oyeniyihakeem08-blip/child-wearable-notification-bracelet/Docs/Childcare website screnshot.png

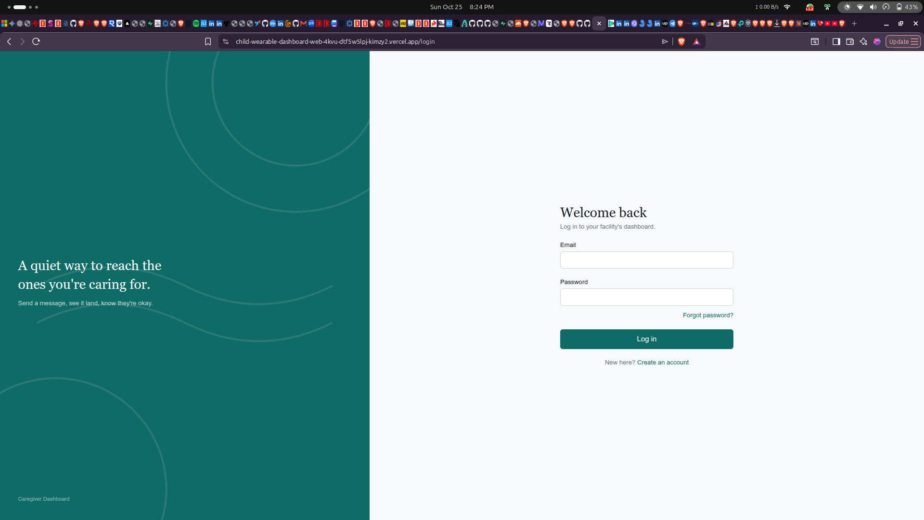
Docs/Childcare website screnshot.png
