oyeniyihakeem08-blip/child-wearable-notification-bracelet/Docs/dashboard.png

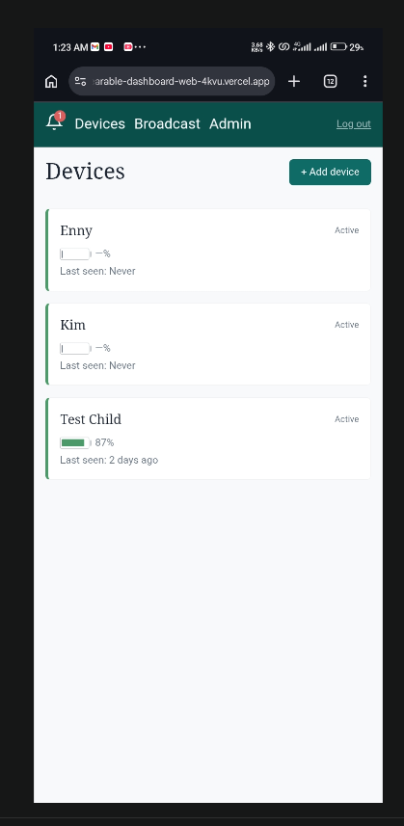
Docs/dashboard.png
