oyeniyihakeem08-blip/child-wearable-notification-bracelet/Child wereble Fabrication files/Bom.csv

Designator | Footprint | Quantity | Value | LCSC Part #
C1, C6, C7 | 0603 | 3 | 1uf | C59782
C2 | 0603 | 1 | 0.1uf | C15725
C3, C4, C5 | 0603 | 3 | 10uf | C19702
D1 | D_SOD-123 | 1 | 1N4148W | C81598
J3 | CON_5034801200_MOL | 1 | 5034801200 | C3169773
Q1, Q2 | SOT-23 | 2 | AO3400A | C347475
R1, R10, R2, R5, R7, R8, R9 | 0603 | 7 | 10k | C844918
R11, R18, R19 | 0603 | 3 | 4.7k | C844931
R12 | 0603 | 1 | 3.3k | C844928
R13 | 0603 | 1 | 20M | C422963
R14, R16, R17 | 0603 | 3 | 1M | C844922
R15 | 0603 | 1 | 1.05M | C54531148
R20, R3 | 0603 | 2 | 100r | C844917
R21, R4 | 0603 | 2 | 100k | C844916
R6 | 0603 | 1 | 8.2r | C2998143
S1 | SW_TS-1187A-B-A-B | 1 | TS-1187A-B-A-B | C318884
U1 | SOT-23-5 | 1 | AP2112K-3.3 | C51118
U2 | ESP32-S3-WROOM-1 | 1 | ESP32-S3-WROOM-1-N8R8 | C2913201
U3 | VQFN-16-1EP_3x3mm_P0.5mm_EP1.6x1.6mm | 1 | BQ24074RGT | C54313
U5 | 21-0168E_T822-3_MXM | 1 | MAX17048G+T10 | C2682616
U6 | SOT65P210X110-5N | 1 | TLV3691IDCKR | C180352
