oyeniyihakeem08-blip/child-wearable-notification-bracelet/3D models/Fuel guage 21-0168E_T822-3_MXM.step

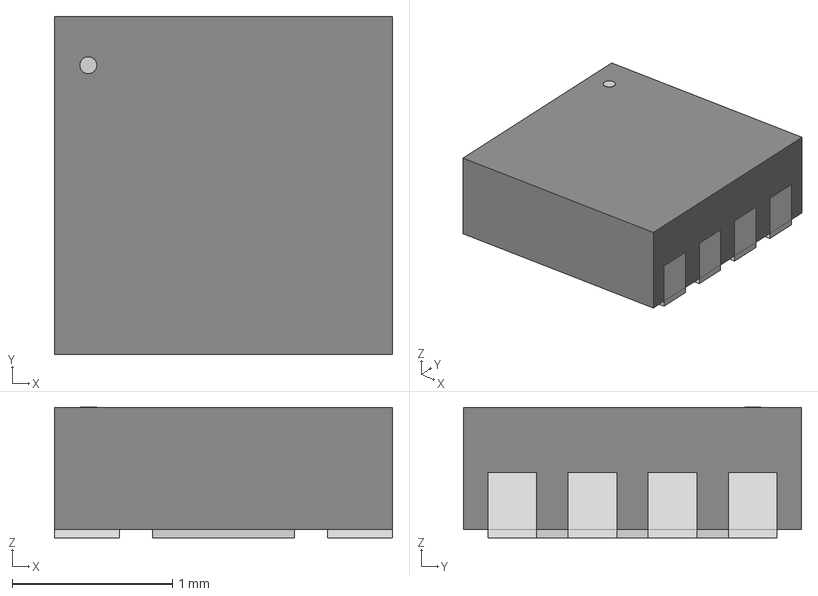
[picture p10: CAD file, 2026-10-25]
3D models/Fuel guage 21-0168E_T822-3_MXM.step
2.11 x 2.11 x 0.815 mm
