oyeniyihakeem08-blip/child-wearable-notification-bracelet/Child wereble Fabrication files/PCB 3D model/Child wereable PCB 3D model.step

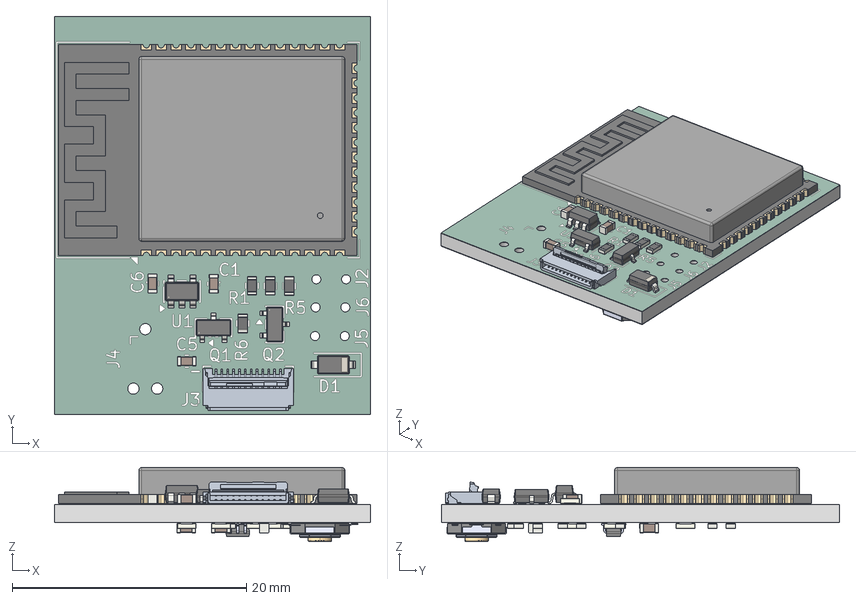
[picture p11: CAD file, 2026-10-25]
Child wereble Fabrication files/PCB 3D model/Child wereable PCB 3D model.step
27.0 x 34.0 x 6.33 mm
R_0603_1608Metric x 21
SOT-23 x 2
D_SOD-123
SOT-23-5
C_0603_1608Metric x 7
ESP32-S3-WROOM-1
TS-1187A-B-A-B
DCK5
Child wereable_silkscreen x 2
Child wereable_soldermask x 2
Child wereable_PCB
