oyeniyihakeem08-blip/child-wearable-notification-bracelet/Child wereble Fabrication files/PDFs/Front Fab.pdf

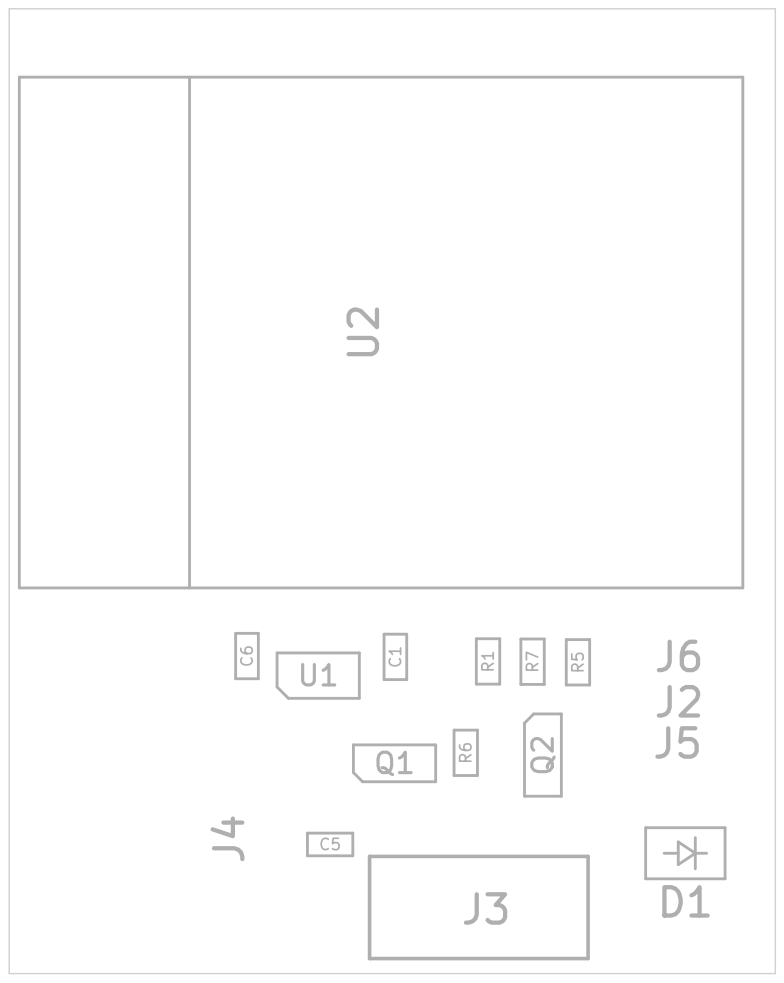
[picture p12: page 1]
