oyeniyihakeem08-blip/child-wearable-notification-bracelet/Child wereble Fabrication files/PDFs/Schematic.pdf

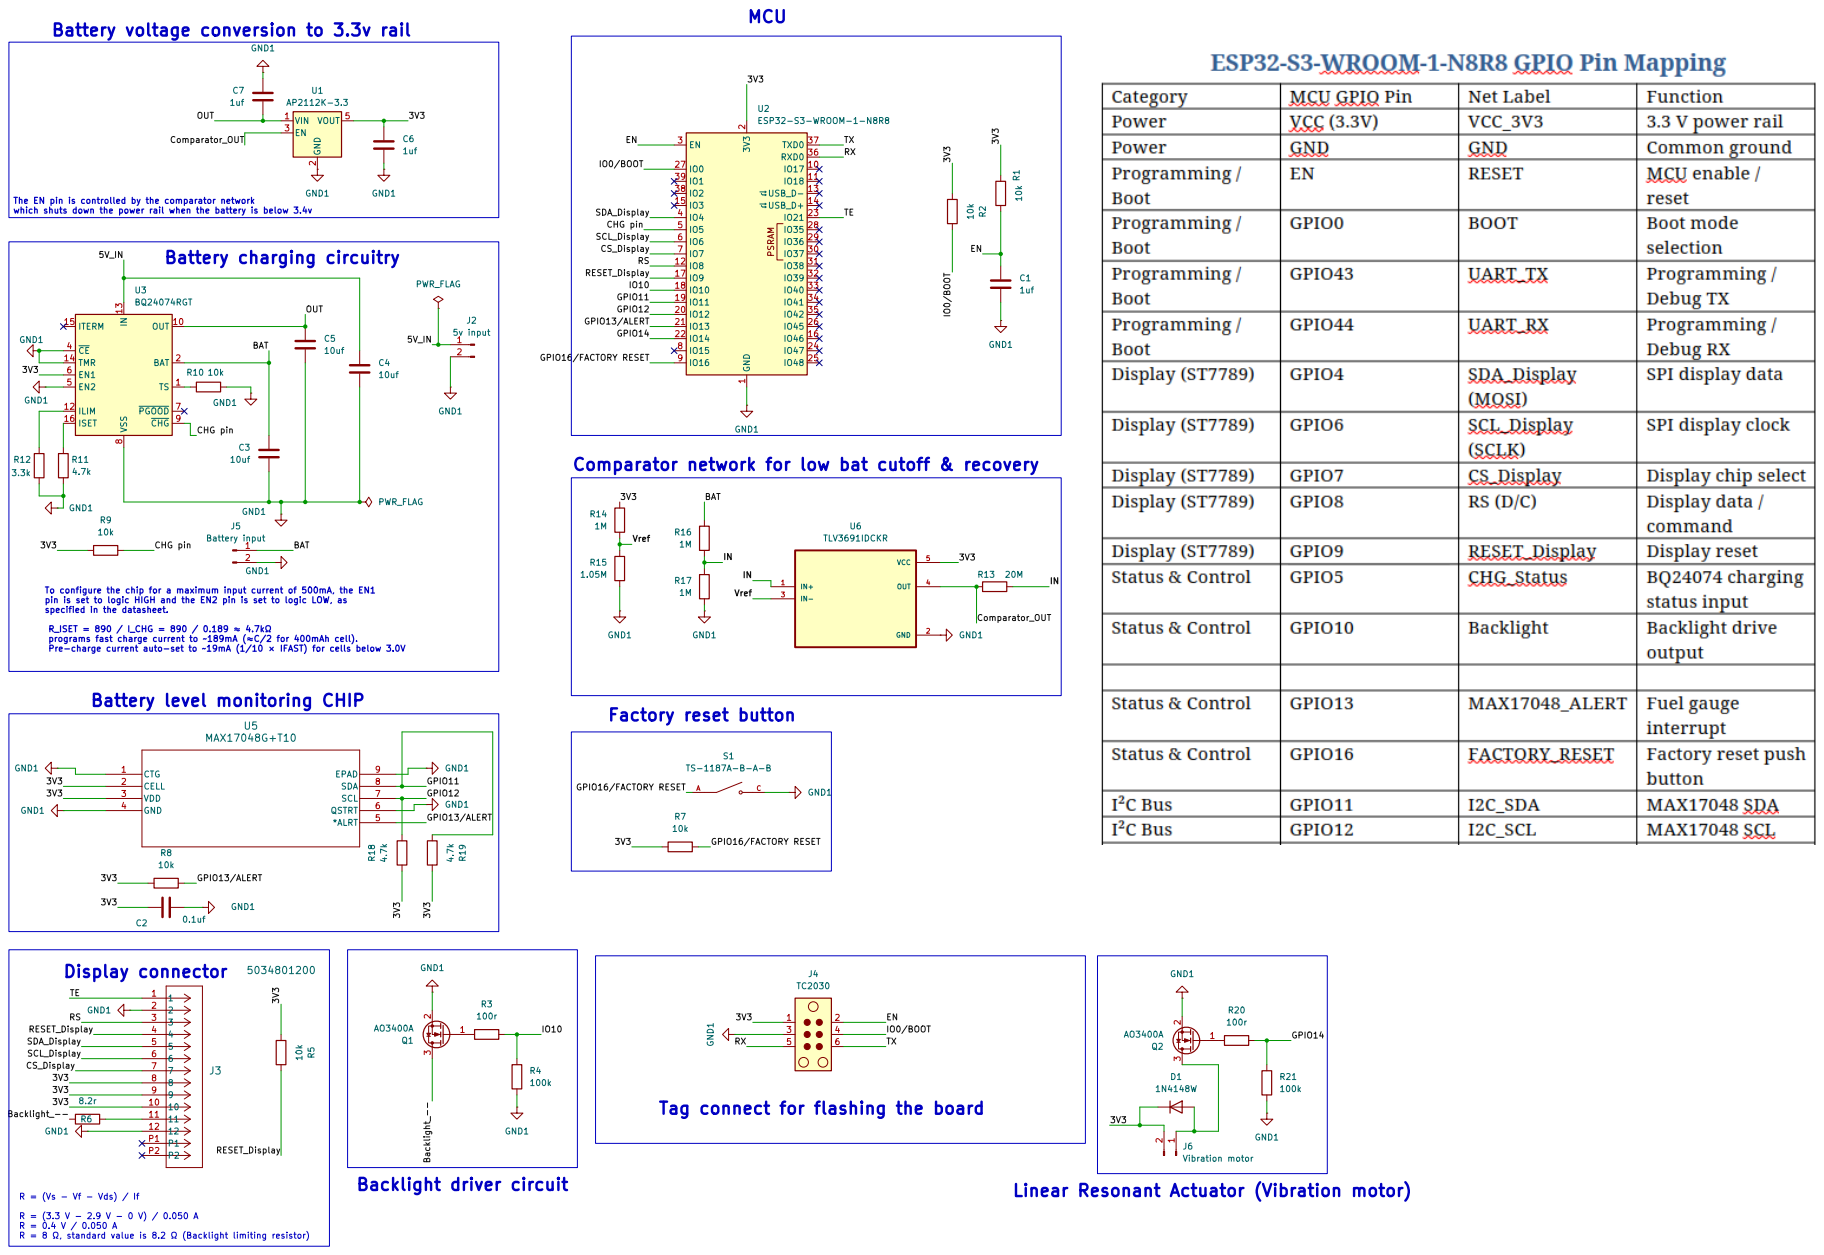
[picture p13: page 1]
