oyeniyihakeem08-blip/child-wearable-notification-bracelet/Docs/Back Fab.pdf

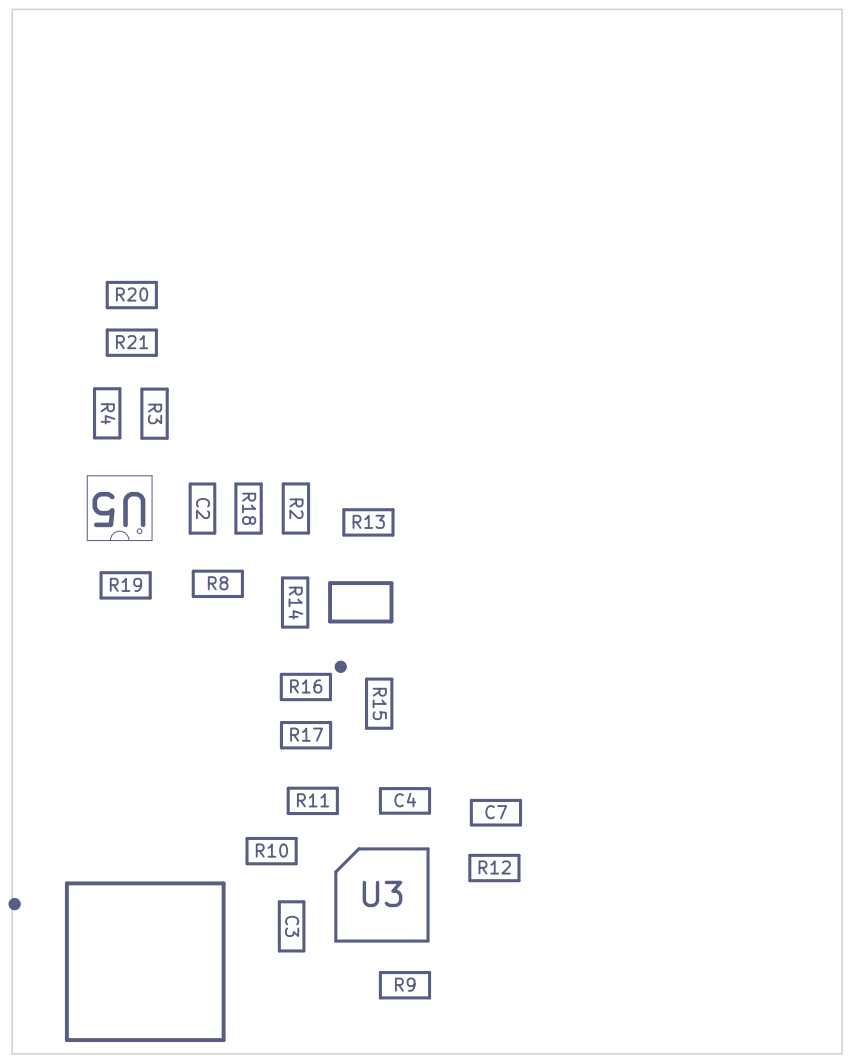
[picture p14: page 1]
