oyeniyihakeem08-blip/child-wearable-notification-bracelet/Child wereable.kicad_pcb

## KiCad design Child wereable.kicad_pcb (2026-10-25)

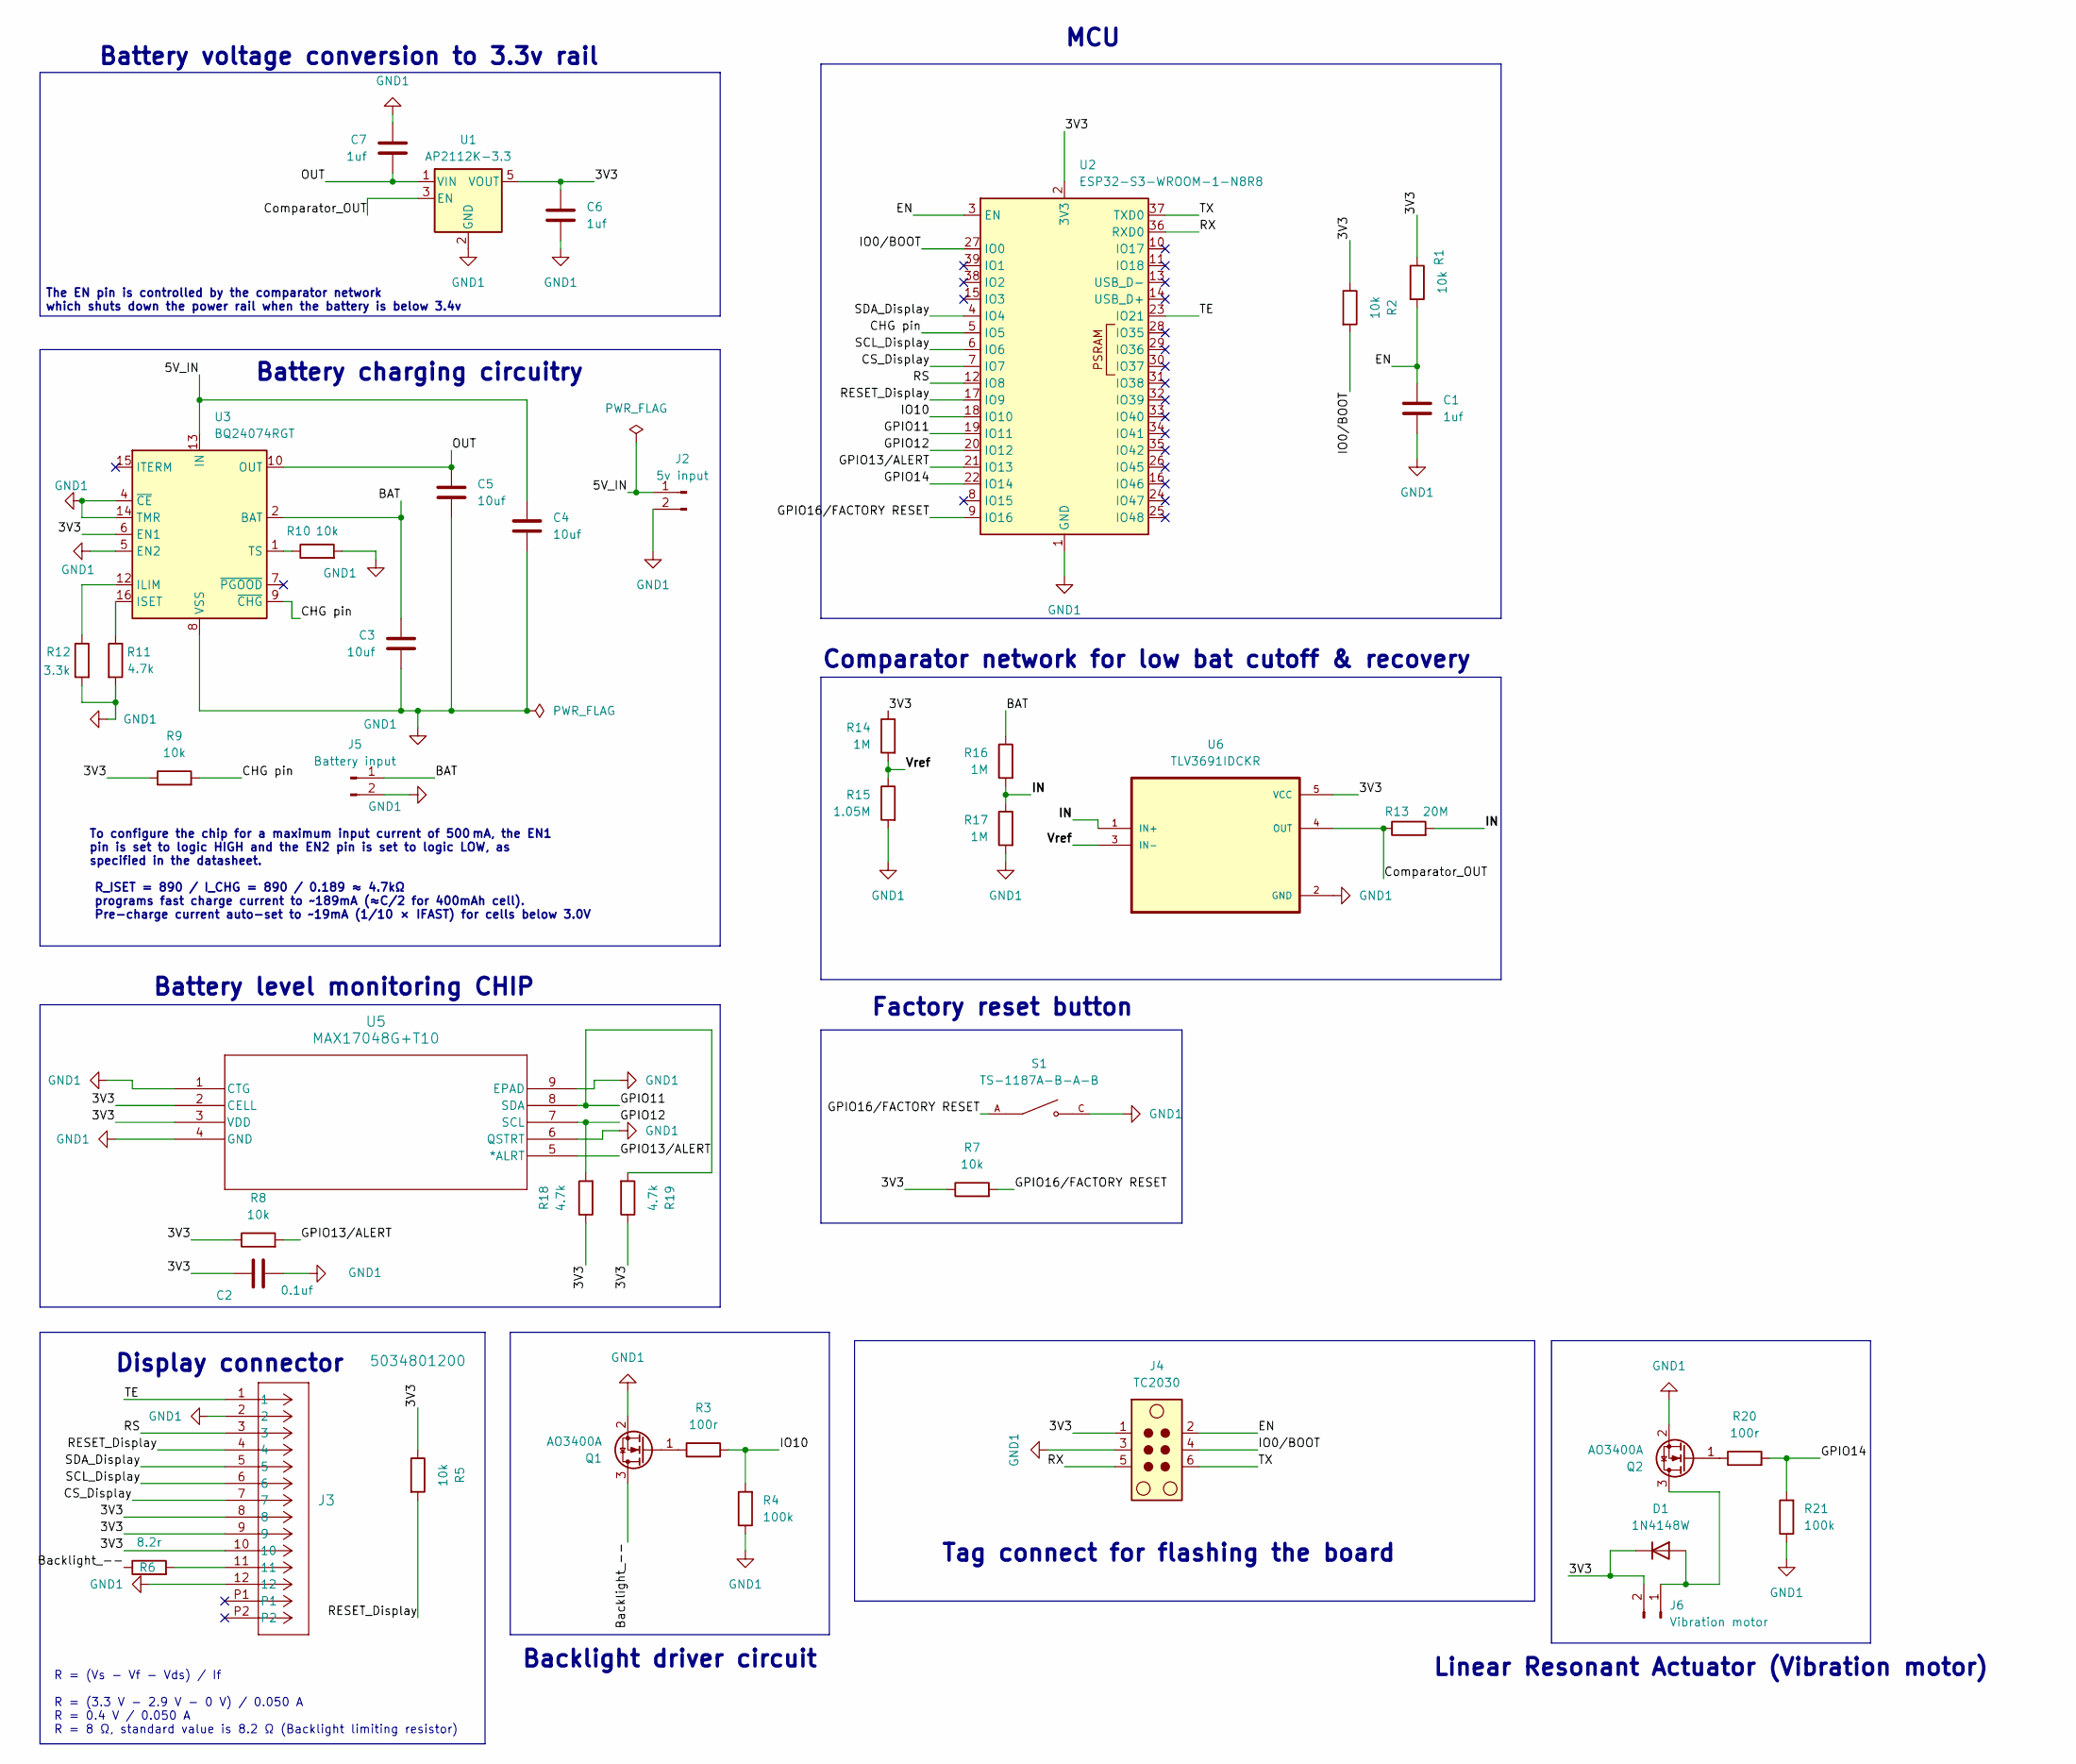
[picture p15: schematic Child wereable.kicad_sch]

Parts:
C1, C6, C7: 1uf; C_0603_1608Metric; LCSC PART NO C59782
C2: 0.1uf; C_0603_1608Metric; LCSC PART NO C15725
C3, C4, C5: 10uf; C_0603_1608Metric; LCSC PART NO C19702
D1: 1N4148W; D_SOD-123; LCSC PART NO C81598
J2: 5v input; TestPoint_2Pads_Pitch2.54mm_Drill0.8mm
J3: 5034801200; CON_5034801200_MOL; LCSC PART NO C3169773
J4: TC2030; Tag-Connect_TC2030-IDC-NL_2x03_P1.27mm_Vertical
J5: Battery input; TestPoint_2Pads_Pitch2.54mm_Drill0.8mm
J6: Vibration motor; TestPoint_2Pads_Pitch2.54mm_Drill0.8mm
Q1, Q2: AO3400A; SOT-23; LCSC PART NO C347475
R1, R2, R5, R7, R8, R9, R10: 10k; R_0603_1608Metric; LCSC PART NO C844918
R3, R20: 100r; R_0603_1608Metric; LCSC PART NO C844917
R4, R21: 100k; R_0603_1608Metric; LCSC PART NO C844916
R6: 8.2r; R_0603_1608Metric; LCSC PART NO C2998143
R11, R18, R19: 4.7k; R_0603_1608Metric; LCSC PART NO C844931
R12: 3.3k; R_0603_1608Metric; LCSC PART NO C844928
R13: 20M; R_0603_1608Metric; LCSC PART NO C422963
R14, R16, R17: 1M; R_0603_1608Metric; LCSC PART NO C844922
R15: 1.05M; R_0603_1608Metric; LCSC PART NO C54531148
S1: TS-1187A-B-A-B; SW_TS-1187A-B-A-B; PARTREV A0; LCSC PART NO C318884
U1: AP2112K-3.3; SOT-23-5; LCSC PART NO C51118
U2: ESP32-S3-WROOM-1-N8R8; ESP32-S3-WROOM-1; LCSC PART NO C2913201
U3: BQ24074RGT; VQFN-16-1EP_3x3mm_P0.5mm_EP1.6x1.6mm; LCSC PART NO C54313
U5: MAX17048G+T10; 21-0168E_T822-3_MXM; LCSC PART NO C2682616
U6: TLV3691IDCKR; SOT65P210X110-5N; LCSC PART NO C180352

Connections:
/3V3: C2.1, C6.1, D1.1 (K), J3.8, J3.9, J3.10, J4.1, J6.2, R1.1, R2.1, R5.1, R7.1, R8.1, R9.1, R14.1, R18.1, R19.1, U1.5 (VOUT), U2.2 (3V3), U3.6 (EN1), U5.2 (CELL), U5.3 (VDD), U6.5 (VCC)
/5V_IN: C4.1, J2.1, U3.13 (IN)
/BAT: C3.1, J5.1, R16.1, U3.2 (BAT), U3.3 (BAT)
/Backlight_--: Q1.3 (D), R6.1
/CHG pin: R9.2, U2.5 (IO5), U3.9 (~CHG)
/CS_Display: J3.7, U2.7 (IO7)
/Comparator_OUT: R13.1, U1.3 (EN), U6.4 (OUT)
/EN: C1.1, J4.2, R1.2, U2.3 (EN)
/GPIO11: R19.2, U2.19 (IO11), U5.8 (SDA)
/GPIO12: R18.2, U2.20 (IO12), U5.7 (SCL)
/GPIO13/ALERT: R8.2, U2.21 (IO13), U5.5 (*ALRT)
/GPIO14: R20.2, R21.2, U2.22 (IO14)
/GPIO16/FACTORY RESET: R7.2, S1.A, S1.B, U2.9 (IO16)
/IN: R13.2, R16.2, R17.1, U6.1 (IN+)
/IO0/BOOT: J4.4, R2.2, U2.27 (IO0)
/IO10: R3.2, R4.2, U2.18 (IO10)
/OUT: C5.2, C7.2, U1.1 (VIN), U3.10 (OUT), U3.11 (OUT)
/RESET_Display: J3.4, R5.2, U2.17 (IO9)
/RS: J3.3, U2.12 (IO8)
/RX: J4.5, U2.36 (RXD0)
/SCL_Display: J3.6, U2.6 (IO6)
/SDA_Display: J3.5, U2.4 (IO4)
/TE: J3.1, U2.23 (IO21)
/TX: J4.6, U2.37 (TXD0)
/Vref: R14.2, R15.1, U6.3 (IN-)
GND1: C1.2, C2.2, C3.2, C4.2, C5.1, C6.2, C7.1, J2.2, J3.2, J3.12, J4.3, J5.2, Q1.2 (S), Q2.2 (S), R4.1, R10.2, R11.2, R12.2, R15.2, R17.2, R21.1, S1.C, S1.D, U1.2 (GND), U2.1 (GND), U2.40 (GND), U2.41 (GND), U3.4 (~CE), U3.5 (EN2), U3.8 (VSS), U3.14 (TMR), U3.17 (VSS), U5.1 (CTG), U5.4 (GND), U5.6 (QSTRT), U5.9 (EPAD), U6.2 (GND)
unnamed: D1.2 (A), J6.1, Q2.3 (D)
unnamed: J3.11, R6.2
unnamed: Q1.1 (G), R3.1
unnamed: Q2.1 (G), R20.1
unnamed: R12.1, U3.12 (ILIM)
unnamed: R11.1, U3.16 (ISET)
unnamed: R10.1, U3.1 (TS)

Notes on the sheet:
Factory reset button
Backlight driver circuit
Battery level monitoring CHIP
Battery voltage conversion to 3.3v rail
The EN pin is controlled by the comparator network which shuts down the power rail when the battery is below 3.4v
Display connector
To configure the chip for a maximum input current of 500 mA, the EN1 pin is set to logic HIGH and the EN2 pin is set to logic LOW, as specified in the datasheet.
Comparator network for low bat cutoff & recovery
R = (Vs − Vf − Vds) / If R = (3.3 V − 2.9 V − 0 V) / 0.050 A R = 0.4 V / 0.050 A R = 8 Ω, standard value is 8.2 Ω (Backlight limiting resistor)
Linear Resonant Actuator (Vibration motor)
MCU
R_ISET = 890 / I_CHG = 890 / 0.189 ≈ 4.7kΩ programs fast charge current to ~189mA (≈C/2 for 400mAh cell). Pre-charge current auto-set to ~19mA (1/10 × IFAST) for cells below 3.0V
Tag connect for flashing the board
Battery charging circuitry

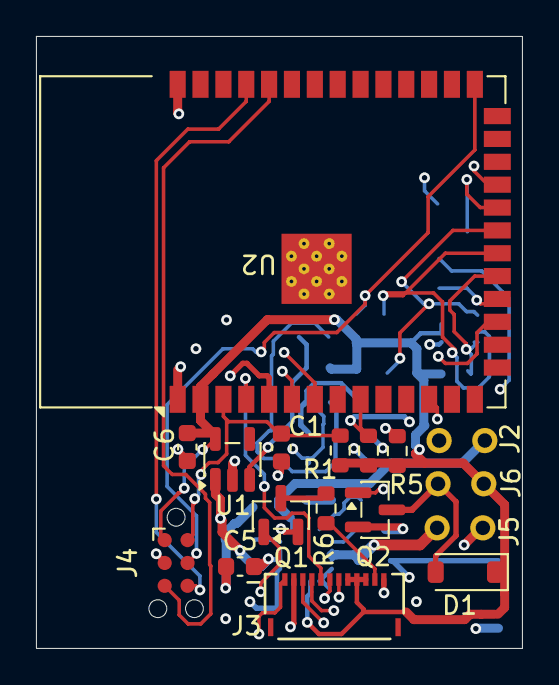
[picture p16: board Child wereable.kicad_pcb from above]

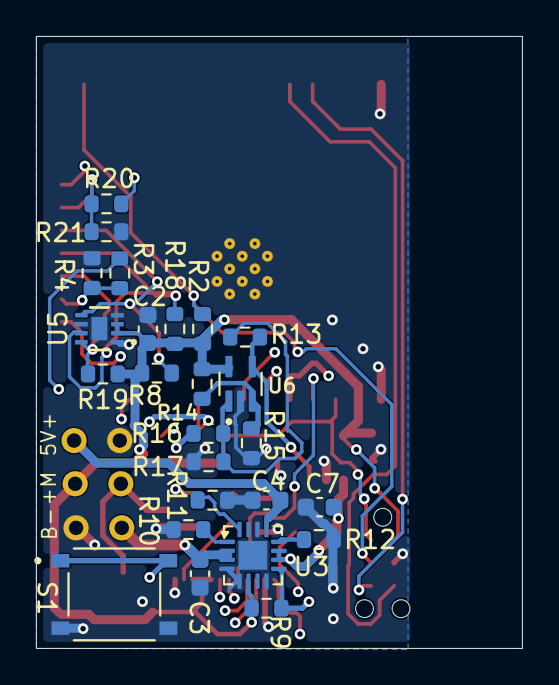
[picture p17: board Child wereable.kicad_pcb from below]

Board: 4 copper layers, 27.0 x 34.0 mm, 42 parts (25 on the bottom side), 33 nets.
